peyman74/RaspberryPico-TwoArms-Robot-Positioning/Dogan Ibrahim - Microcontroller-Based Applied Digital Control.pdf

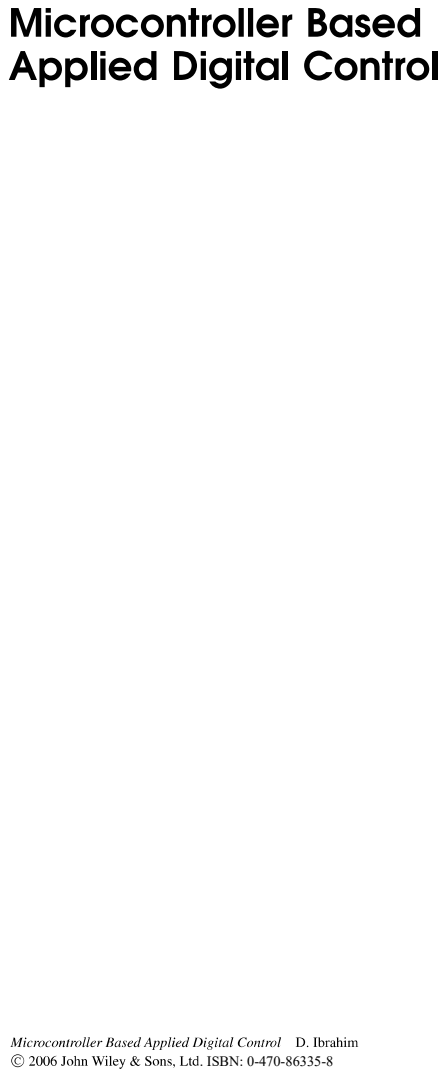
[picture p37: page 1]
. ISBN: 0-470-86335-8

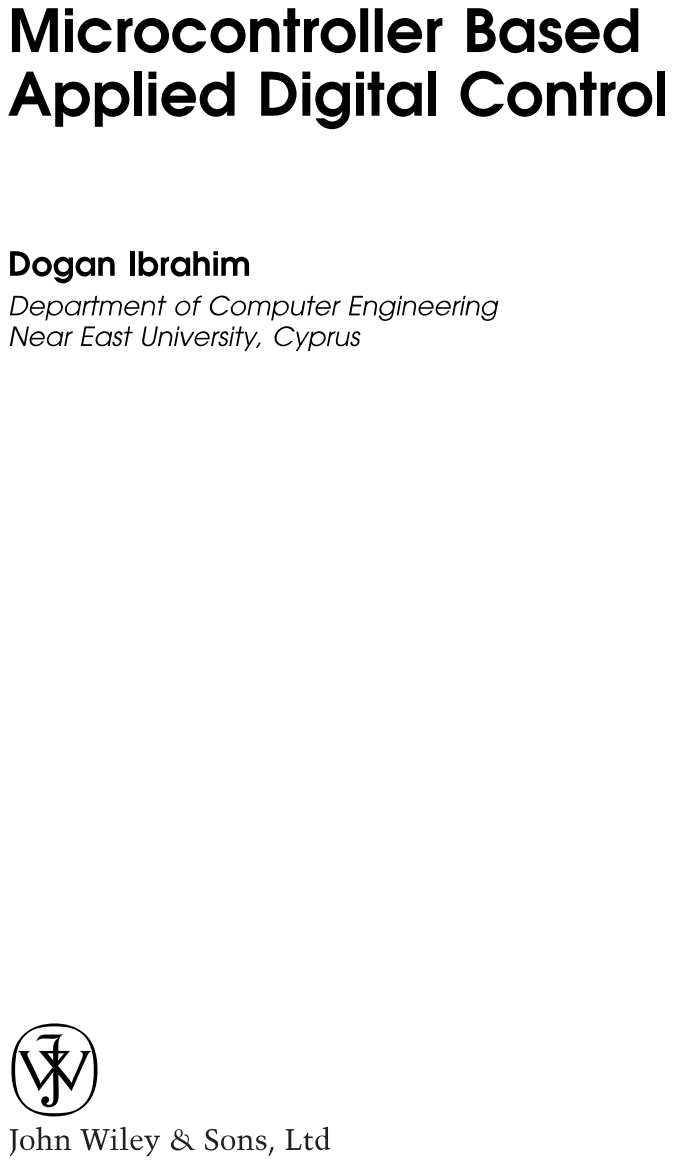
[picture p38: page 2]

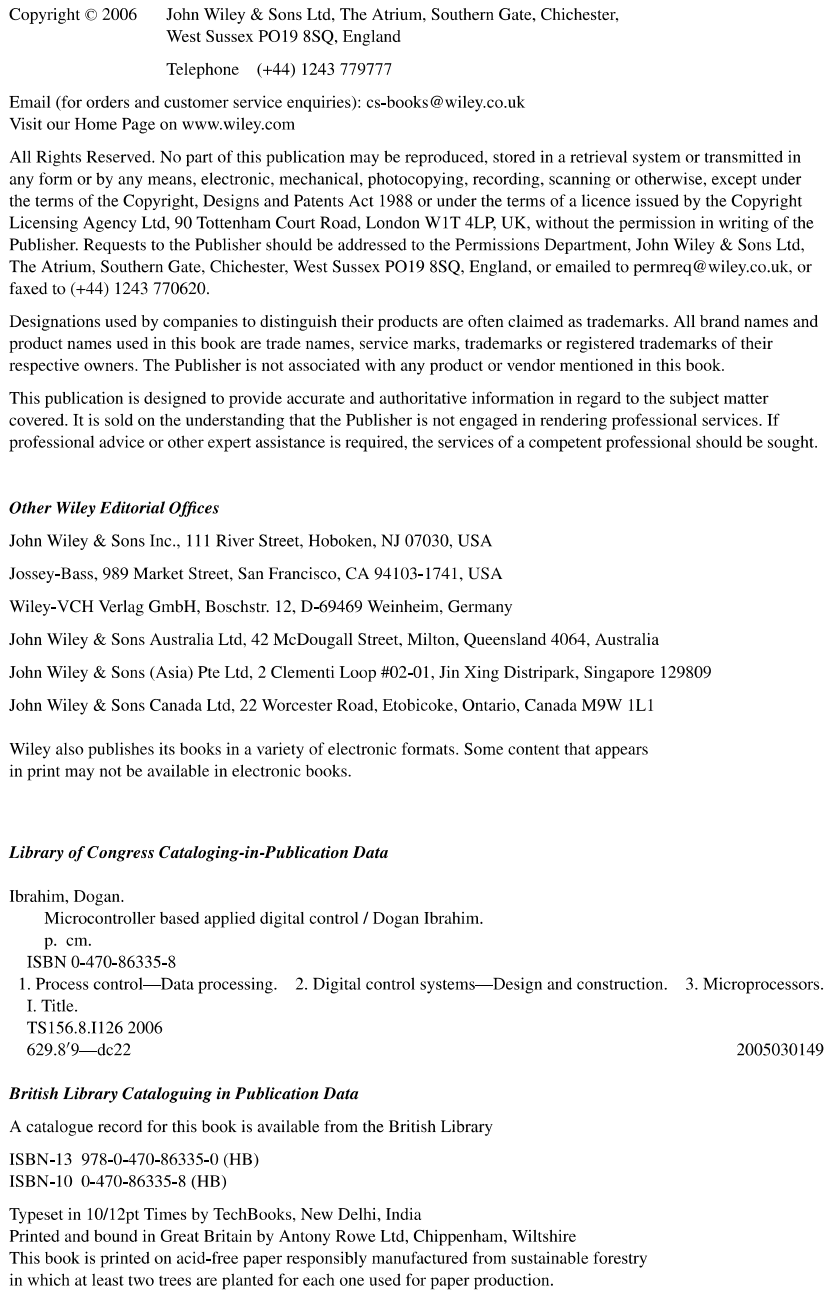
[picture p39: page 3]

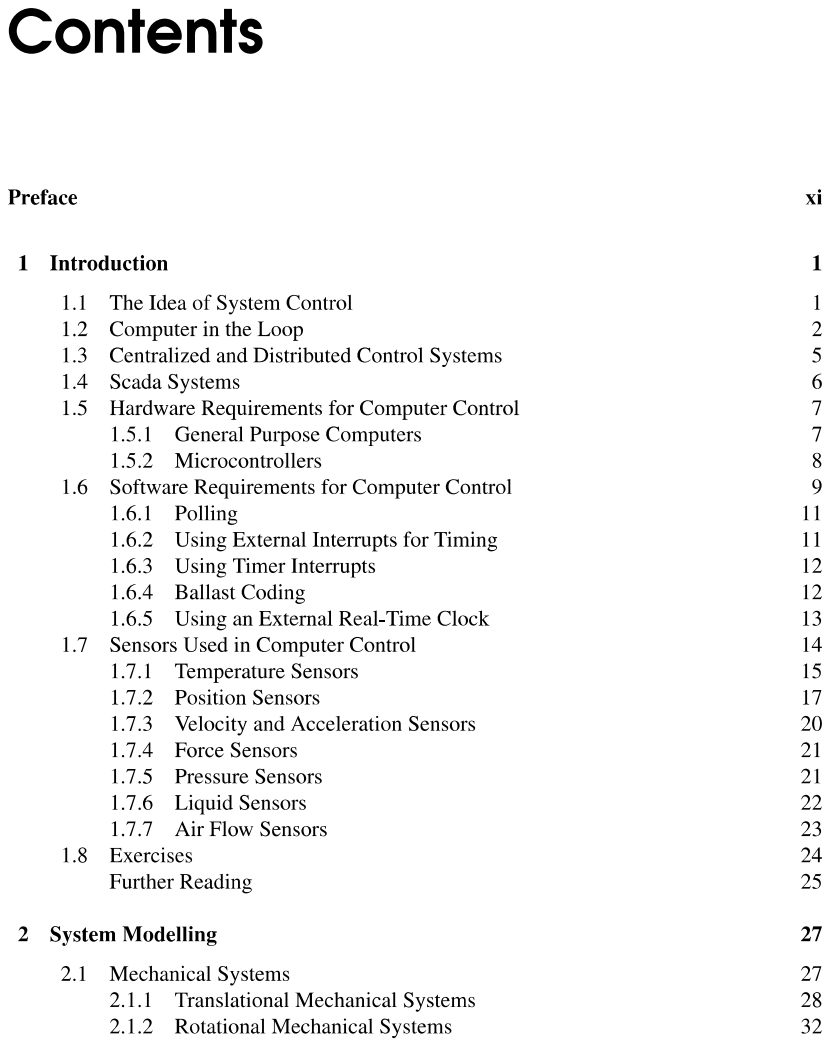
[picture p40: page 4]

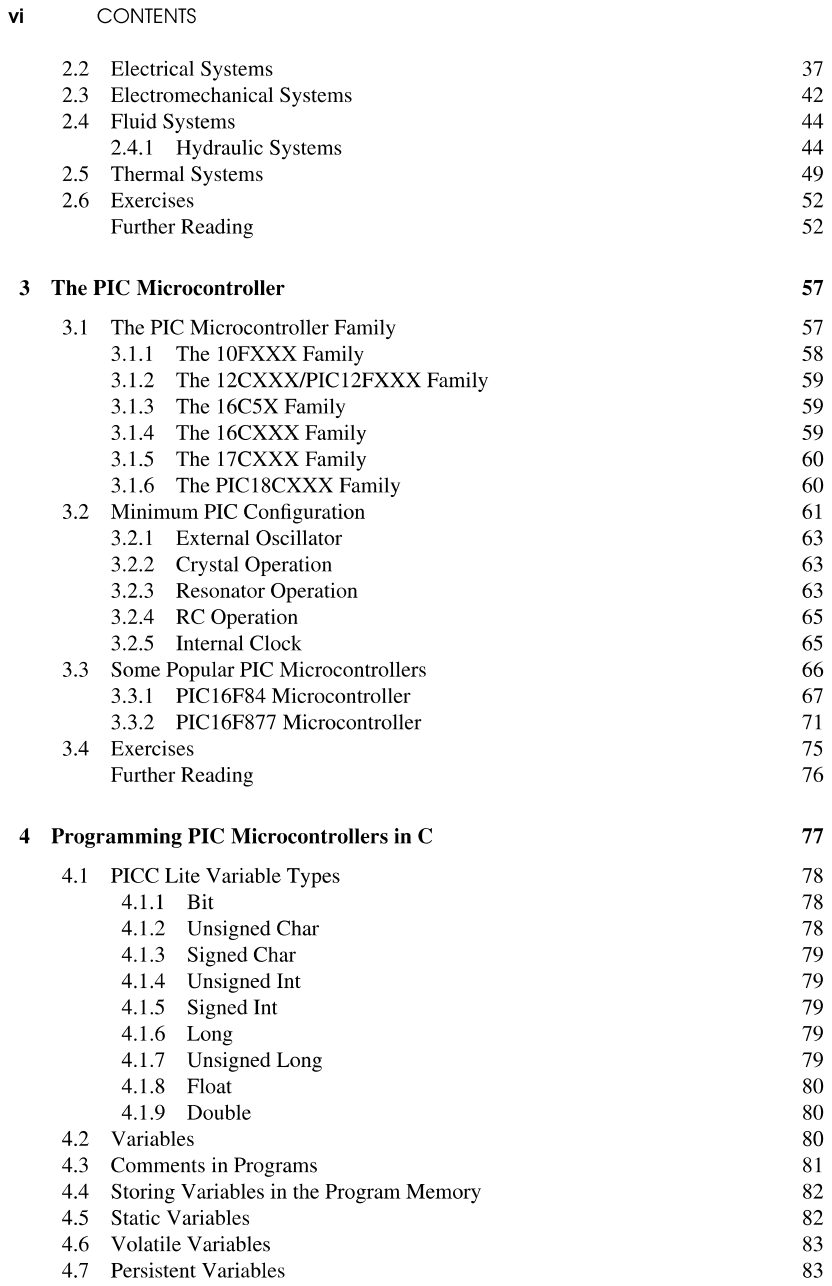
[picture p41: page 5]

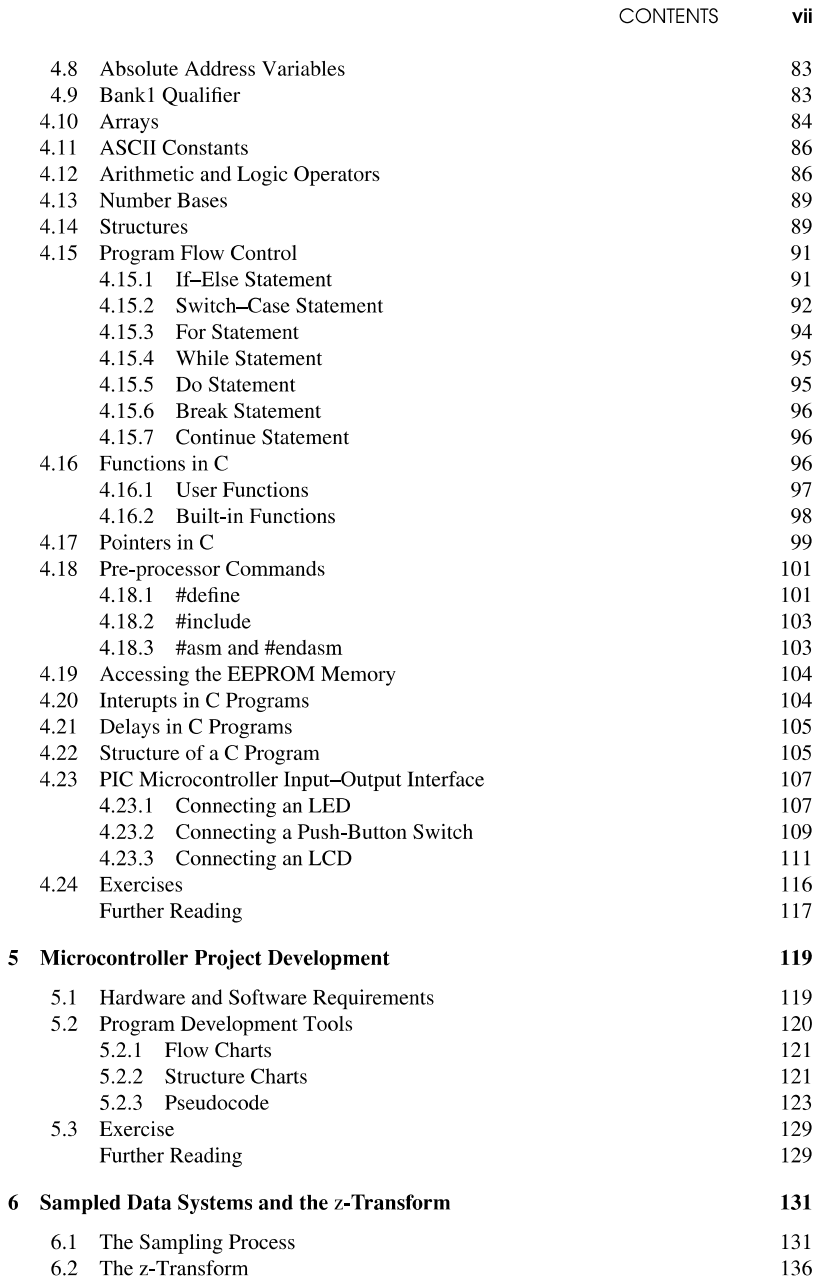
[picture p42: page 6]

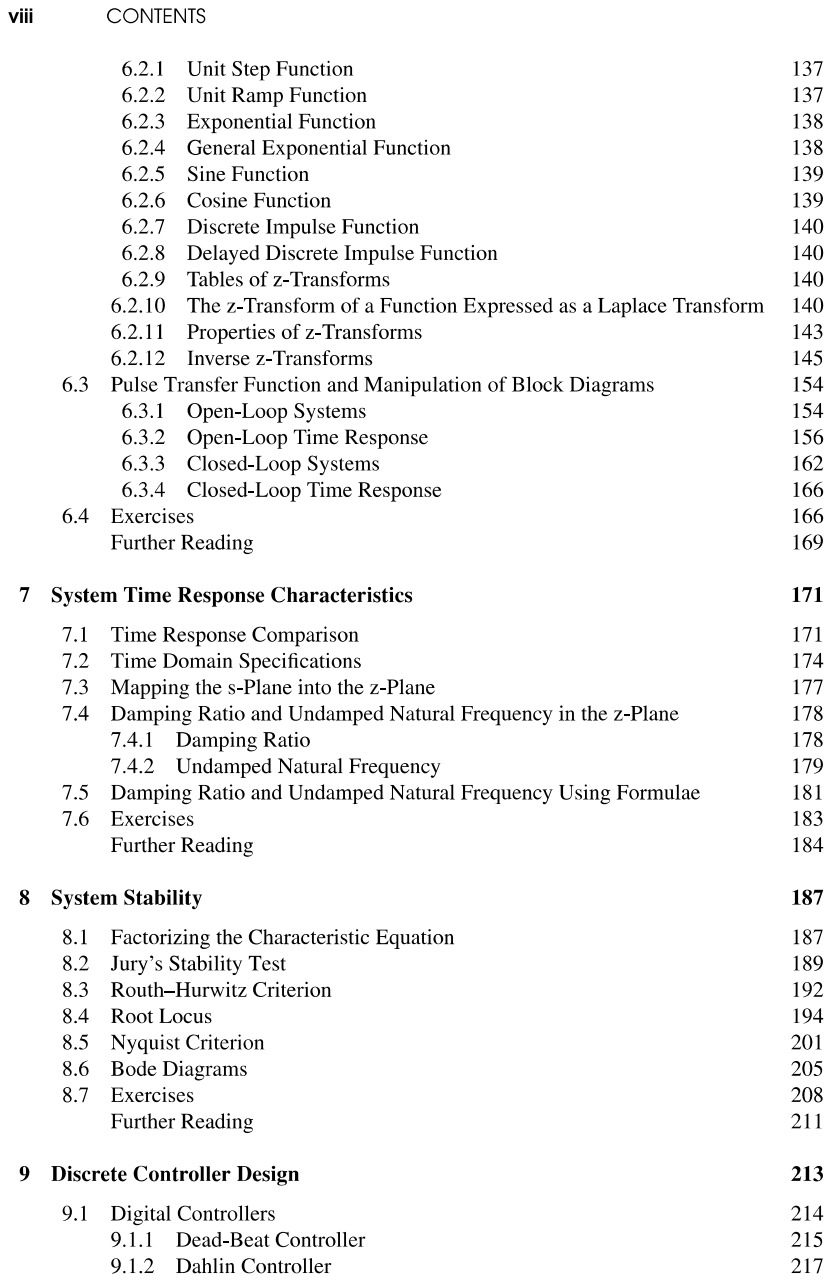
[picture p43: page 7]

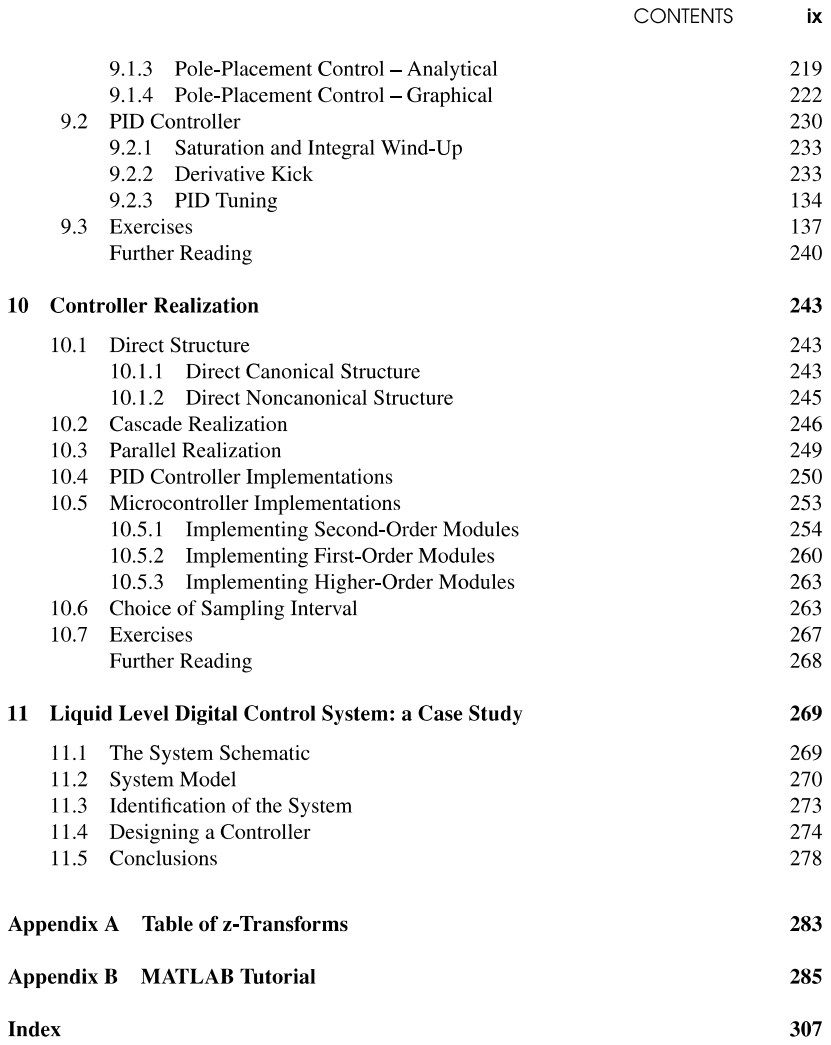
[picture p44: page 8]

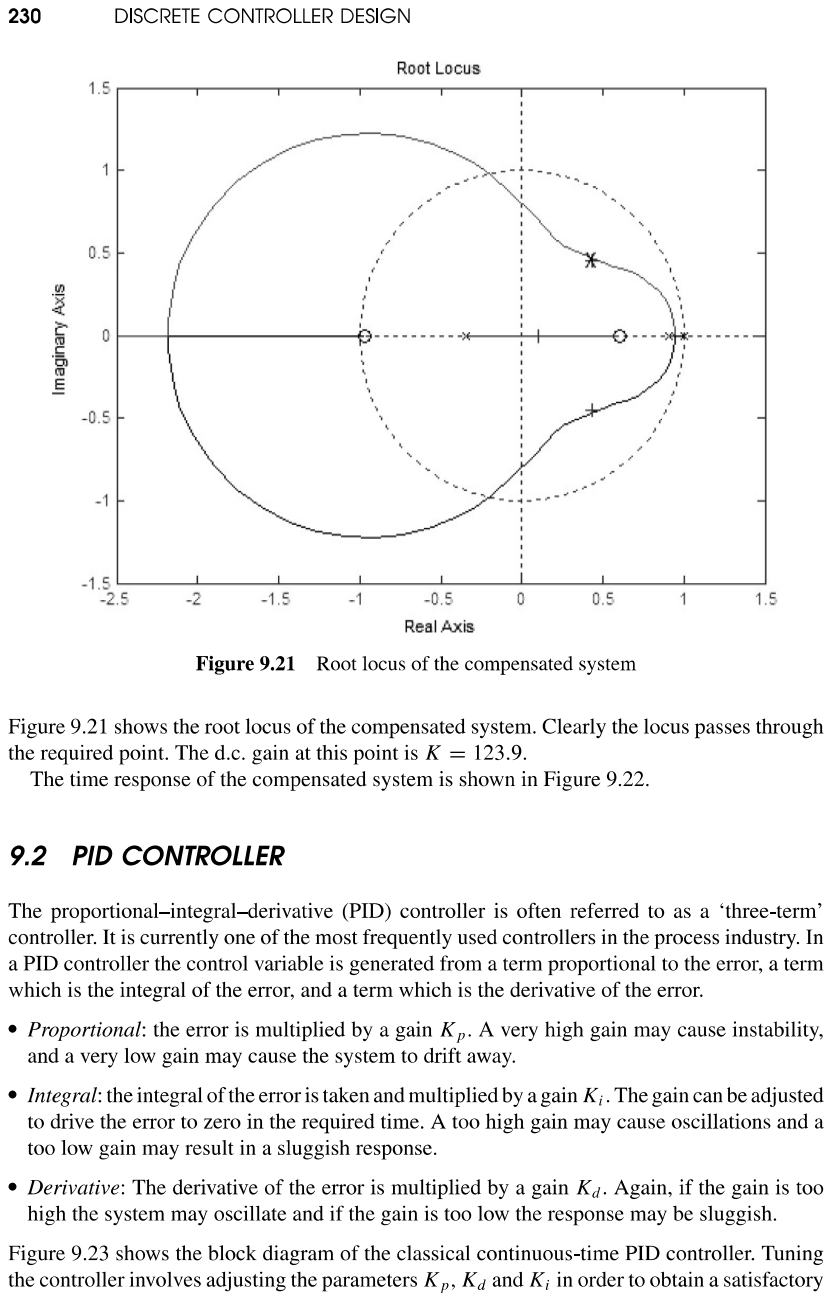
[picture p45: page 9]

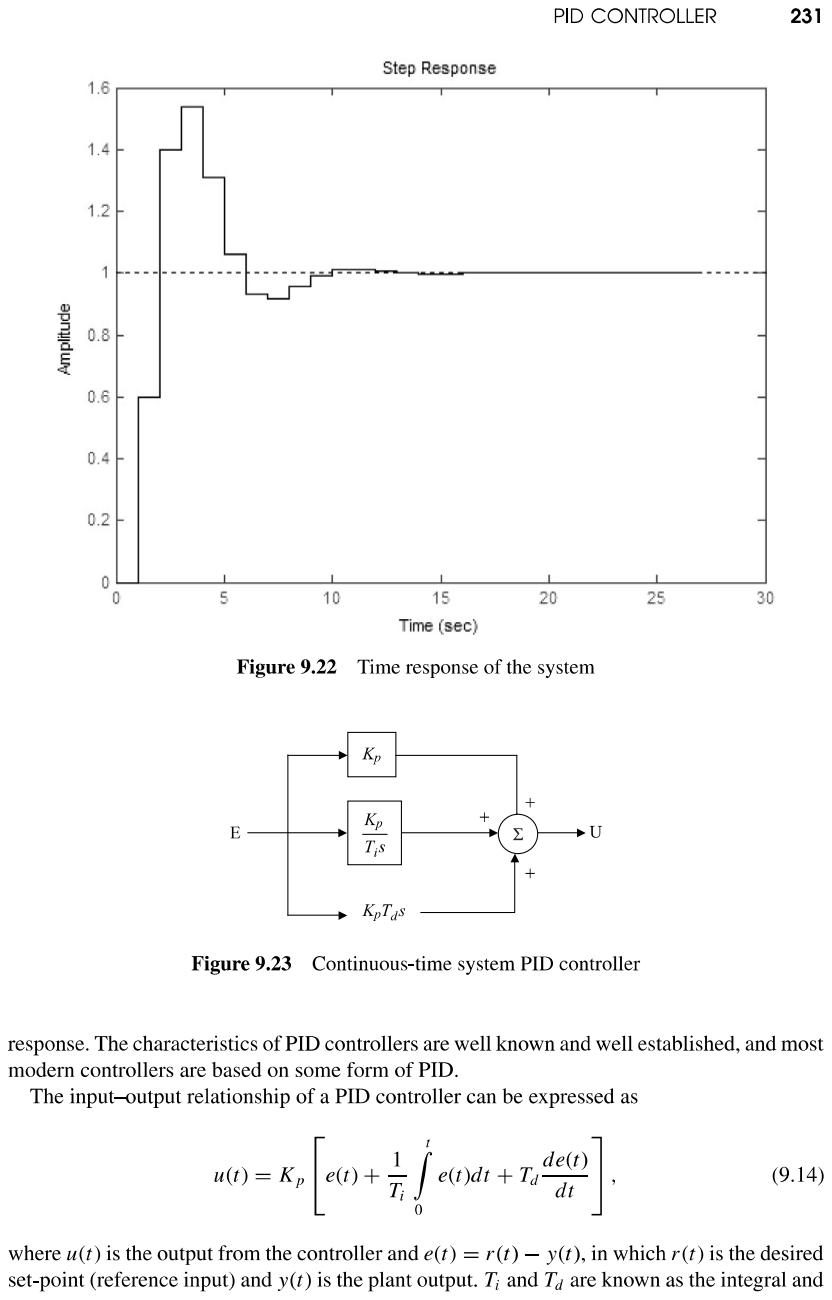
[picture p46: page 10]

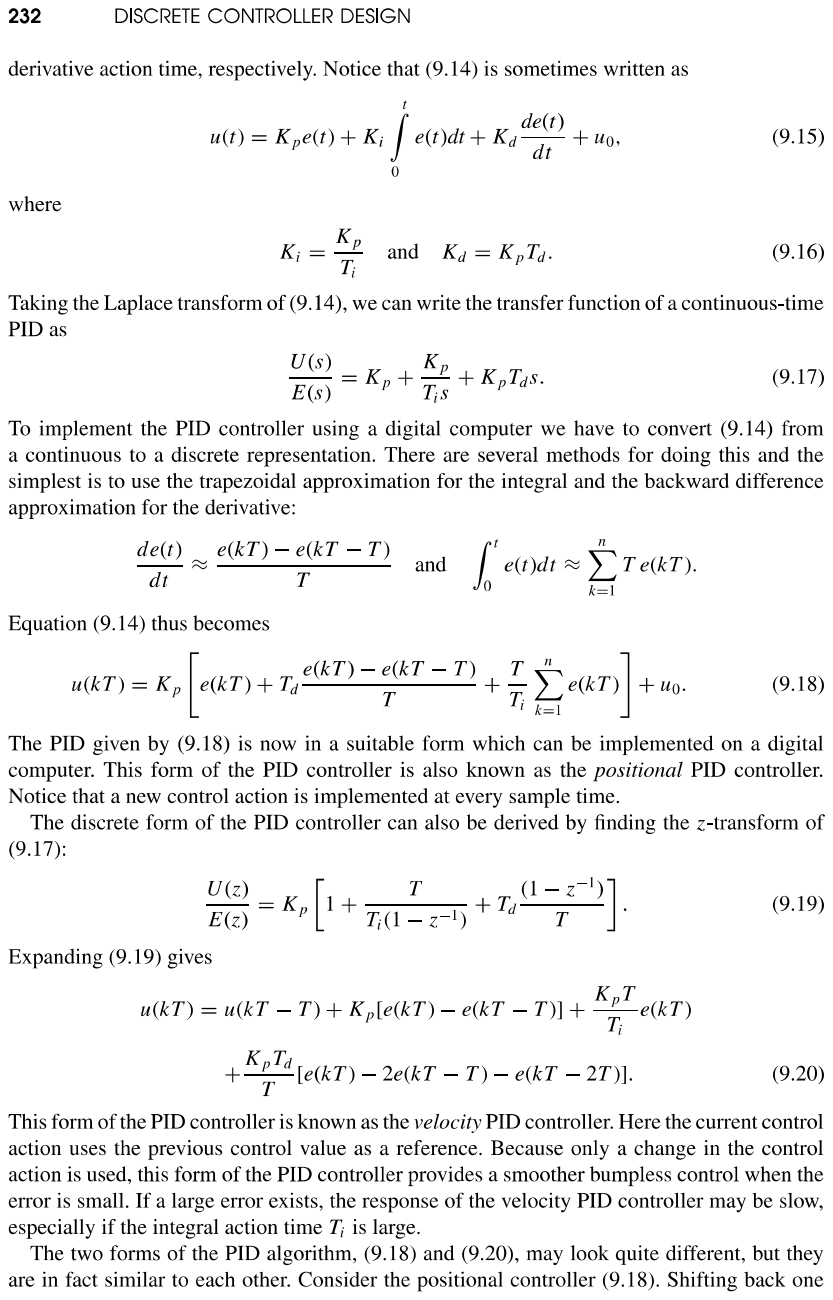
[picture p47: page 11]

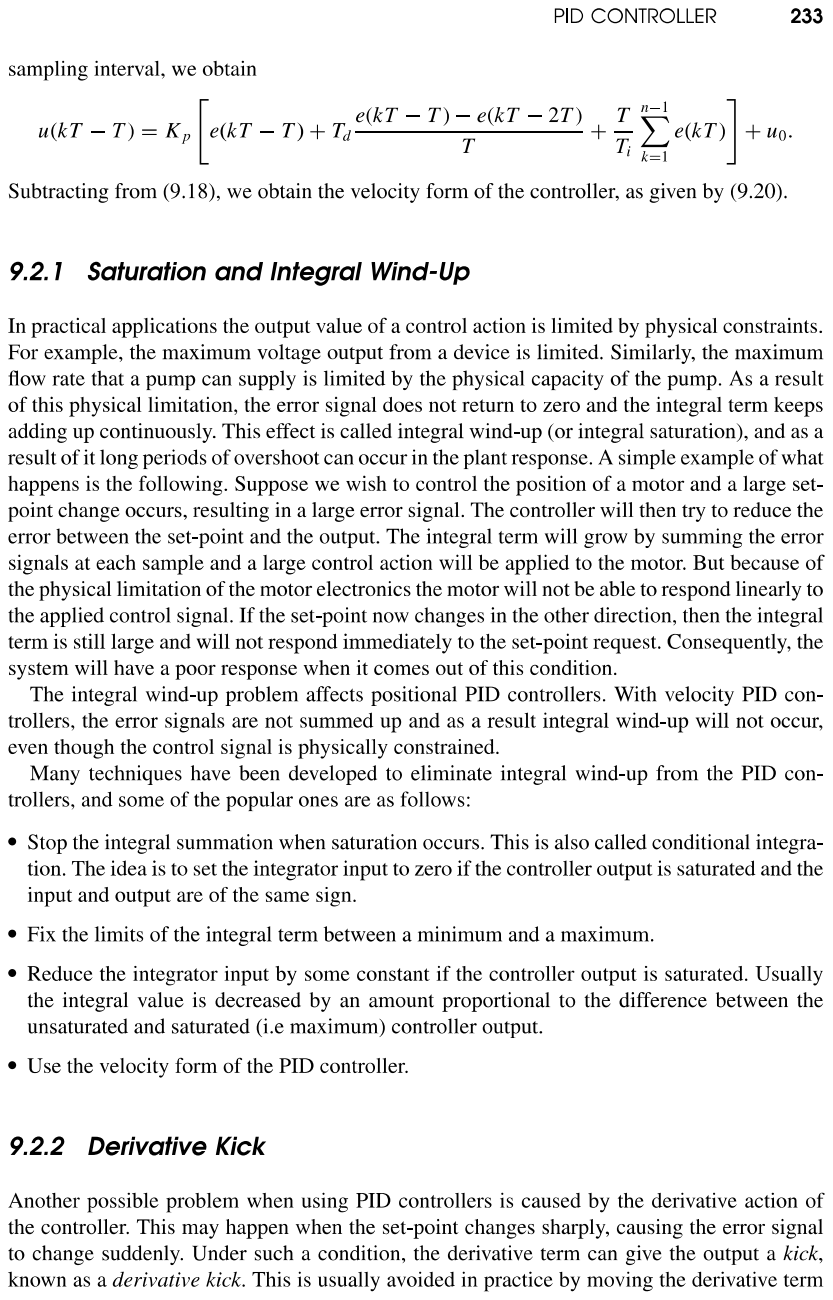
[picture p48: page 12]

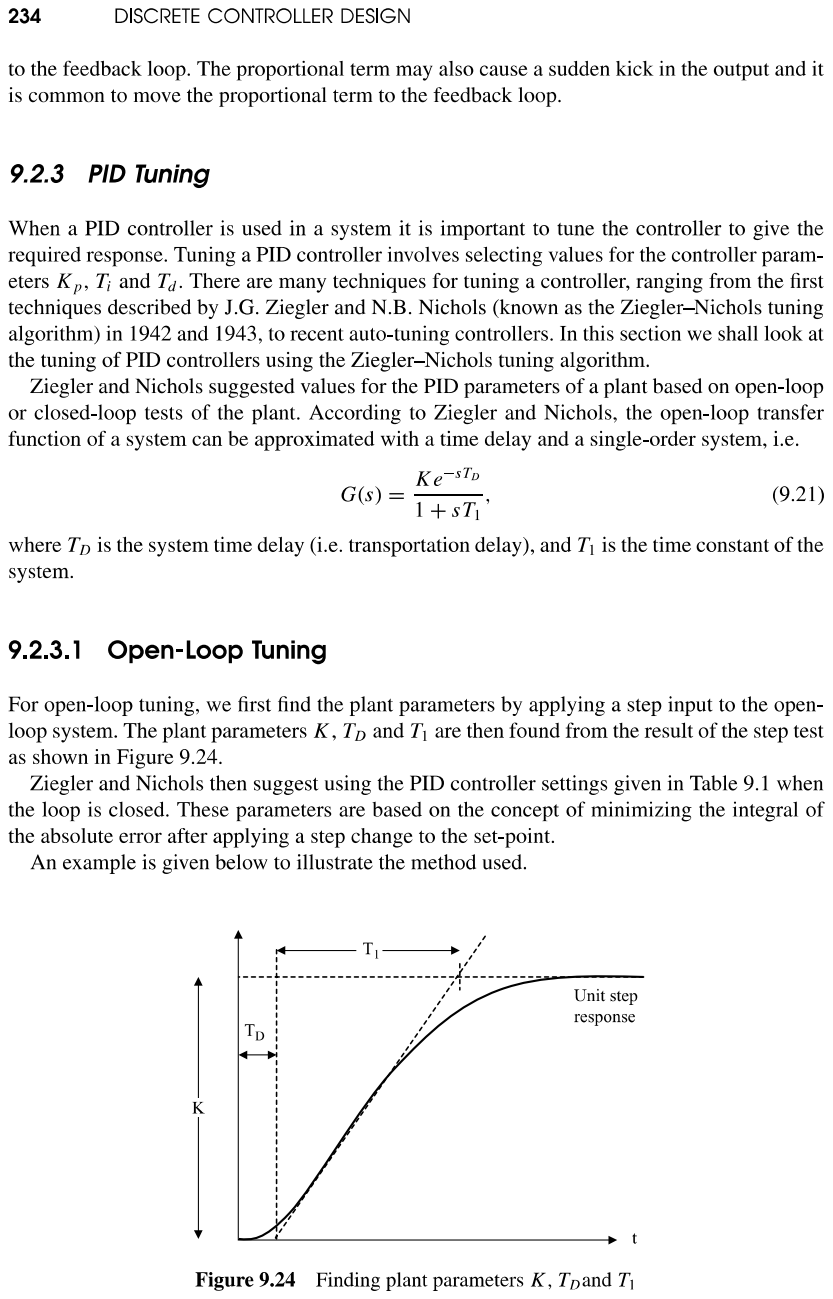
[picture p49: page 13]

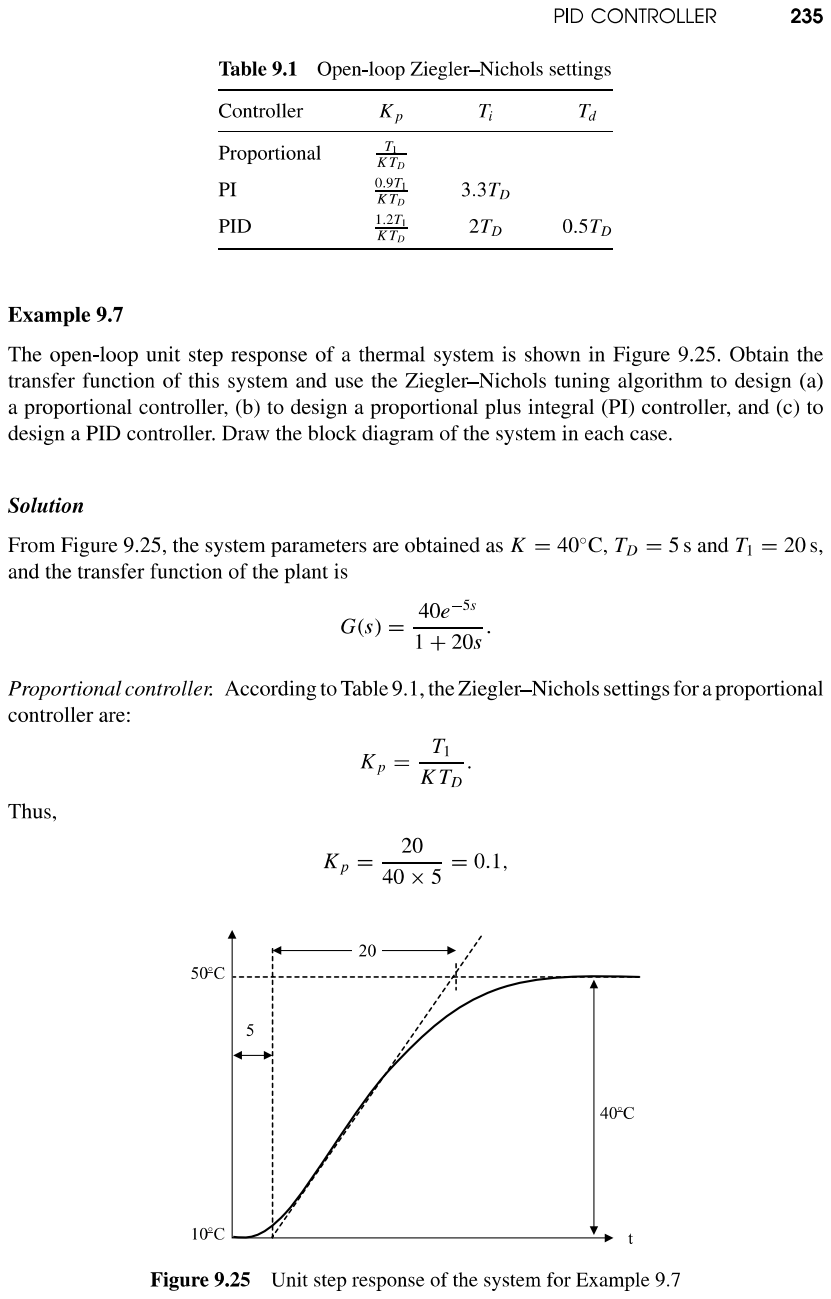
[picture p50: page 14]
