peyman74/RaspberryPico-TwoArms-Robot-Positioning/(commit log)

2026-08-19 Revise directory guidance and control method details
    Updated directory descriptions and control method explanations for the two-arm robotic project.
2026-08-19 Add acknowledgment section to README
    Added acknowledgment to Professor Samuel E. de Lucena for mentoring.
2026-10-27 Update README with project details and features
    Expanded project details, applications, features, and limitations for the two-arm robot positioning project.
